amorenota/Three-Stage-BJT-Audio-Amplifier/hardware/breadboard_implementation.jpg

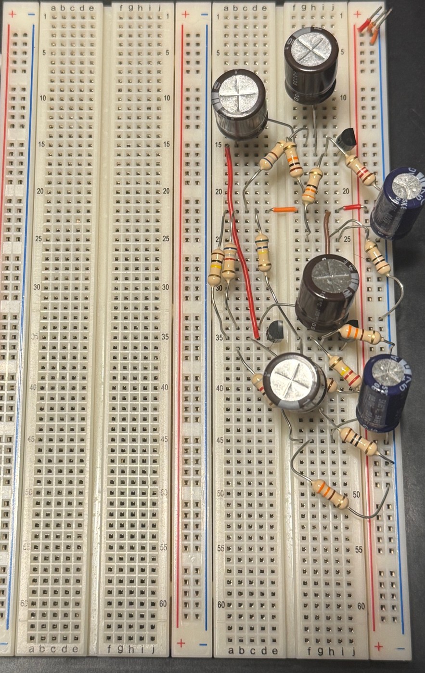
hardware/breadboard_implementation.jpg
