amorenota/Three-Stage-BJT-Audio-Amplifier/reports/progress_report_2.pdf

Adrian Moreno Talavera (SID: 011479859)

Carson Middaugh (SID: 011845185)

Design Project: Progress Report 1

Table 1: Specifications of Amplifier Design
VT | | VCC | AV1 | AV2 | AV3 | VE | IC | VBE | /(1+ ) | iR1
25 mV | 100 | 12 V | -15.6 | -16,8 | 1 | 0.4 V | 1 mA | 0.7 V | 1 | 10Ib

Analysis/Calculations:
Provide appropriate calculations that explain/show how the important parameters associated with each block in the system were determined/designed. Your discussion must also include the process/calculations followed towards determining the schematic component (e.g. resistor, capacitor, etc.) values.

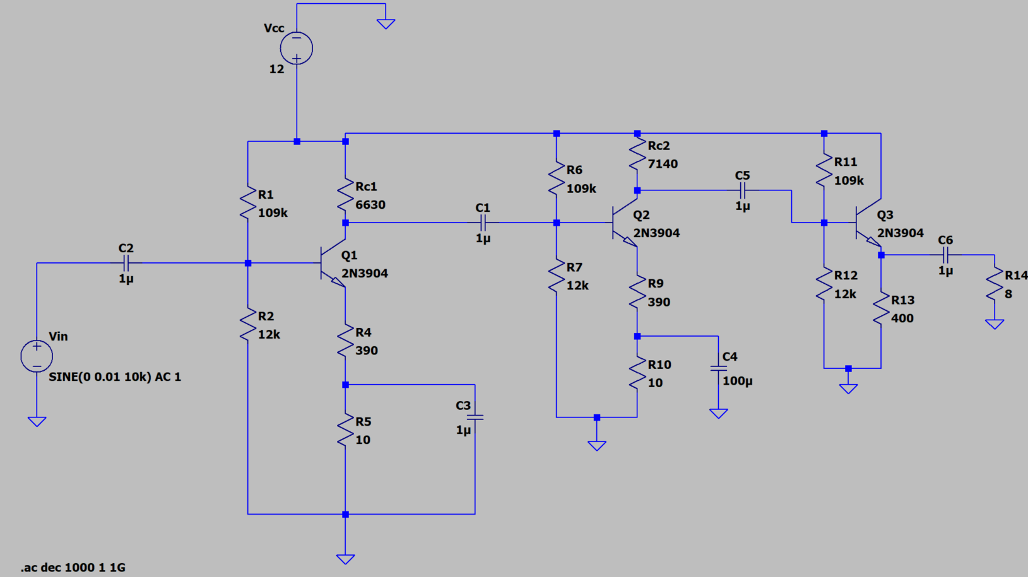
[picture p17: figure]

Figure 1: Cascaded Amplifier Schematic

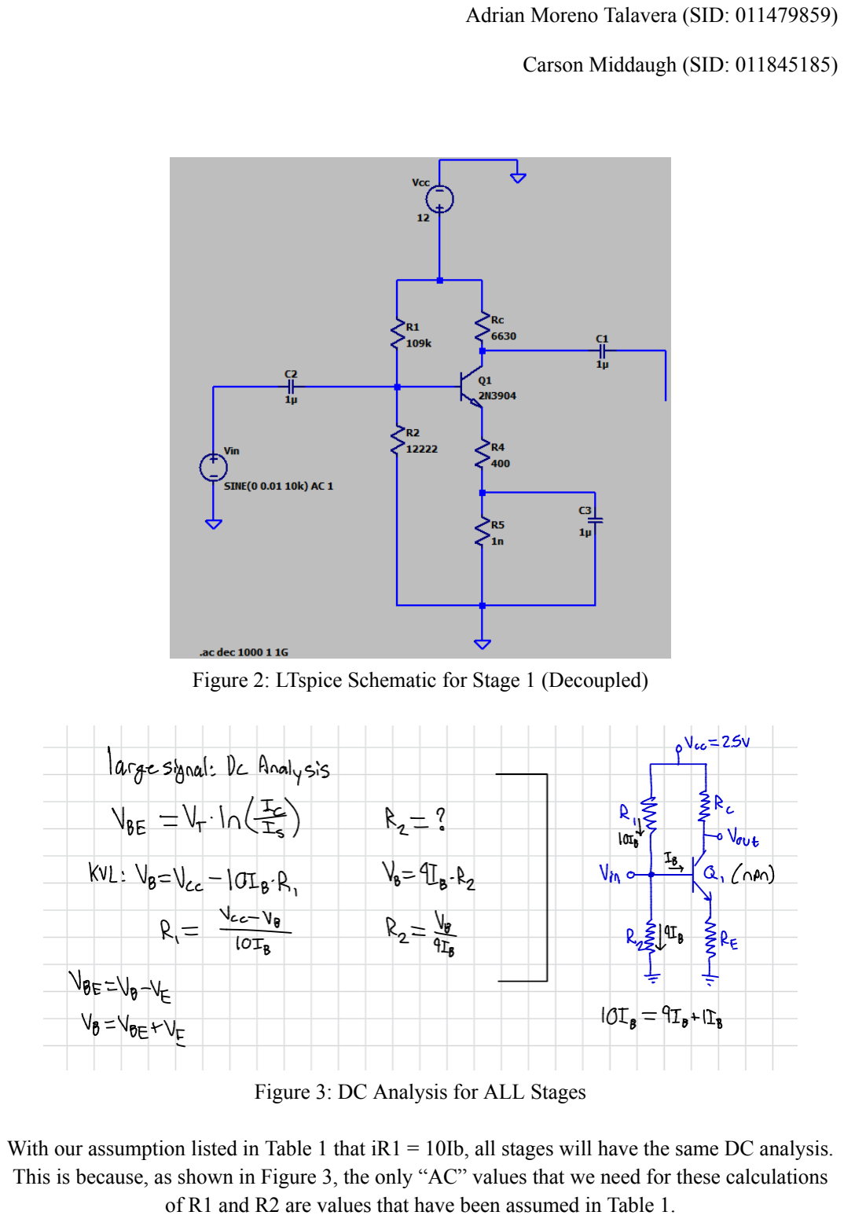
[picture p18: page 2]

Carson Middaugh (SID: 011845185)

Figure 2: LTspice Schematic for Stage 1 (Decoupled)

Figure 3: DC Analysis for ALL Stages

With our assumption listed in Table 1 that iR1 = 10Ib, all stages will have the same DC analysis. This is because, as shown in Figure 3, the only “AC” values that we need for these calculations of R1 and R2 are values that have been assumed in Table 1.

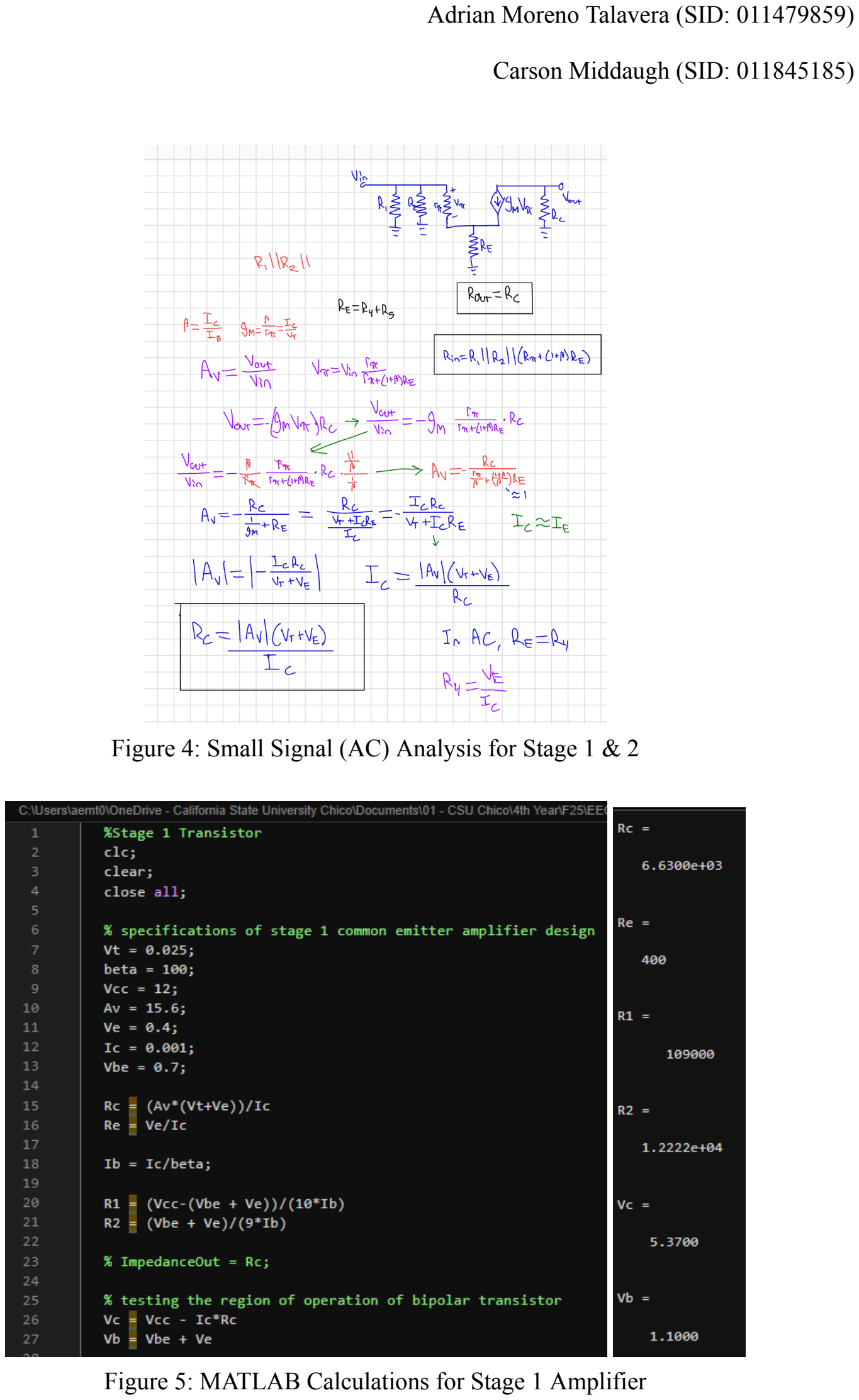
[picture p19: page 3]

Carson Middaugh (SID: 011845185)

Figure 4: Small Signal (AC) Analysis for Stage 1 & 2

Figure 5: MATLAB Calculations for Stage 1 Amplifier

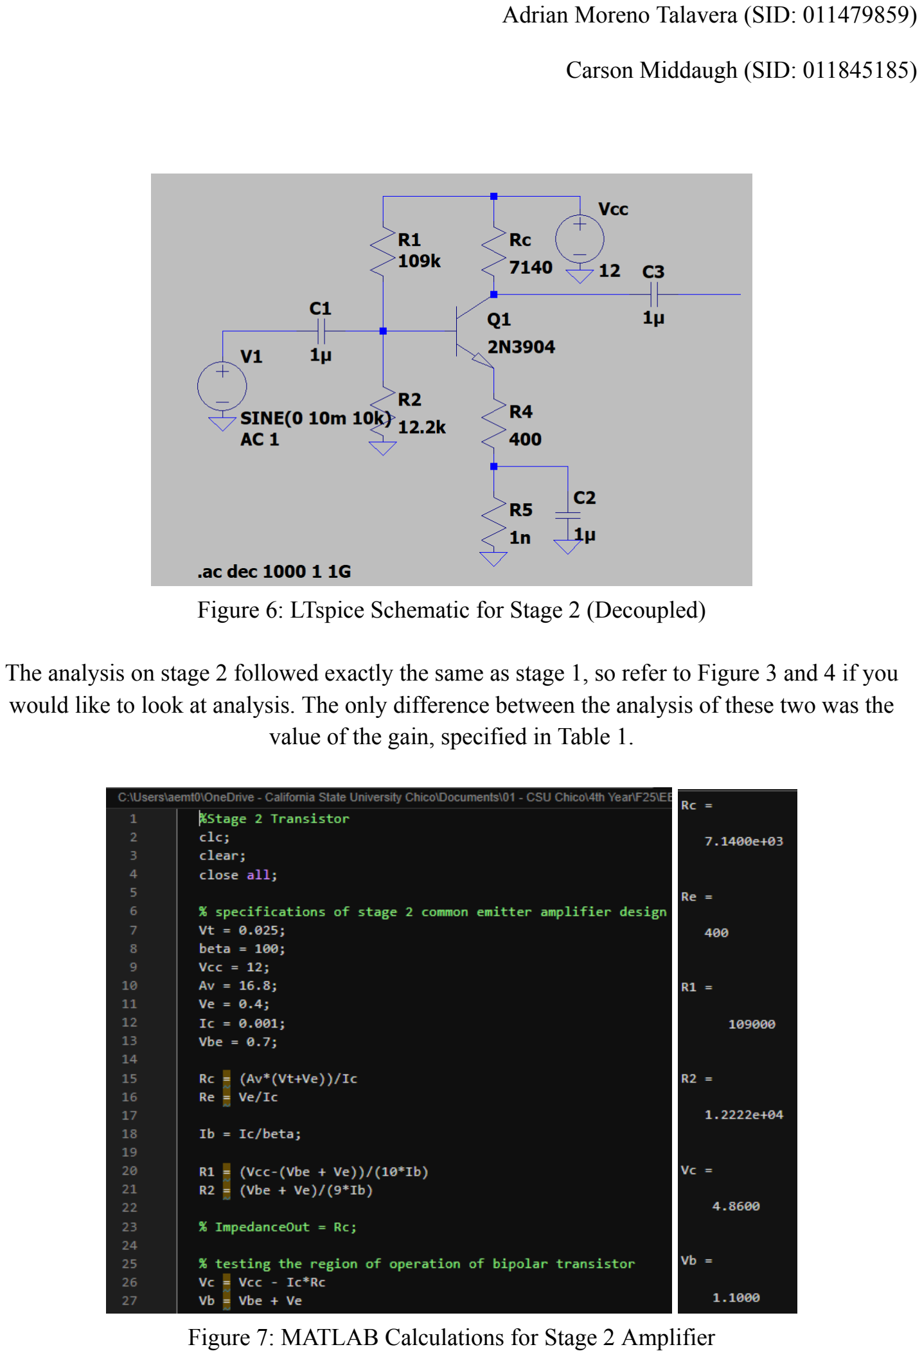
[picture p20: page 4]

Carson Middaugh (SID: 011845185)

Figure 6: LTspice Schematic for Stage 2 (Decoupled)

The analysis on stage 2 followed exactly the same as stage 1, so refer to Figure 3 and 4 if you would like to look at analysis. The only difference between the analysis of these two was the value of the gain, specified in Table 1.

Figure 7: MATLAB Calculations for Stage 2 Amplifier

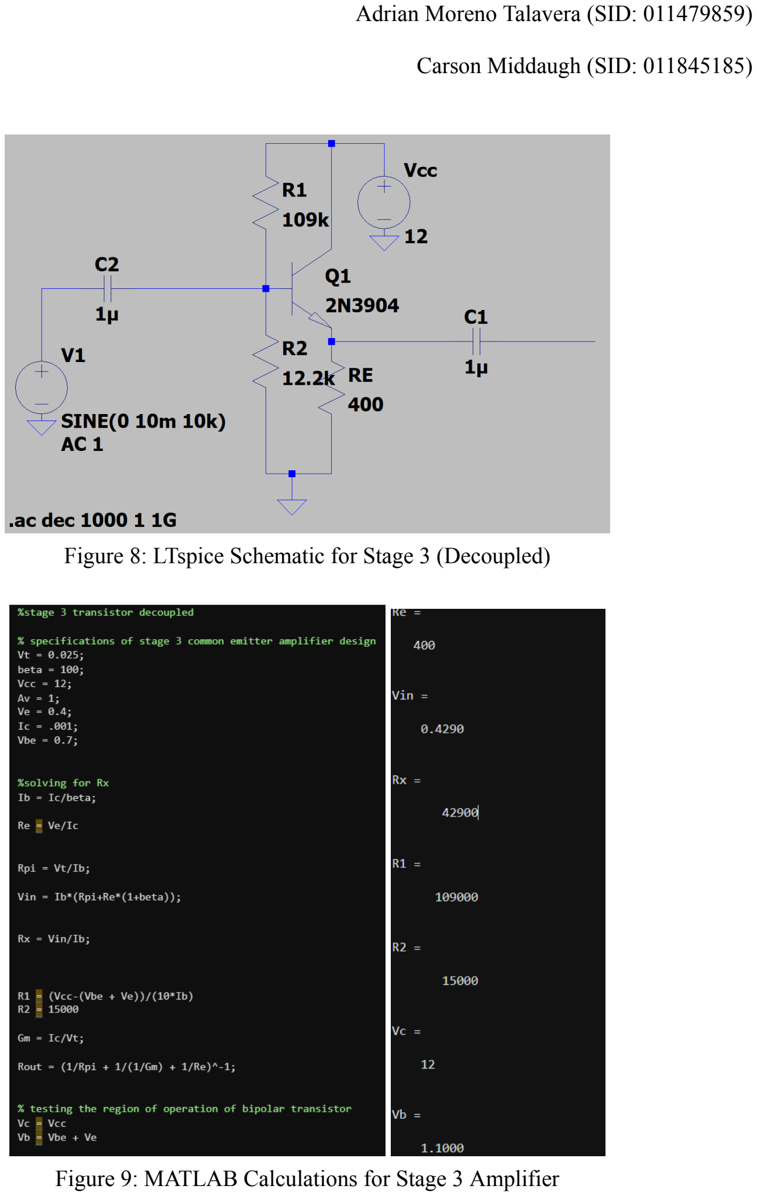
[picture p21: page 5]

Carson Middaugh (SID: 011845185)

Figure 8: LTspice Schematic for Stage 3 (Decoupled)

Figure 9: MATLAB Calculations for Stage 3 Amplifier

Carson Middaugh (SID: 011845185)

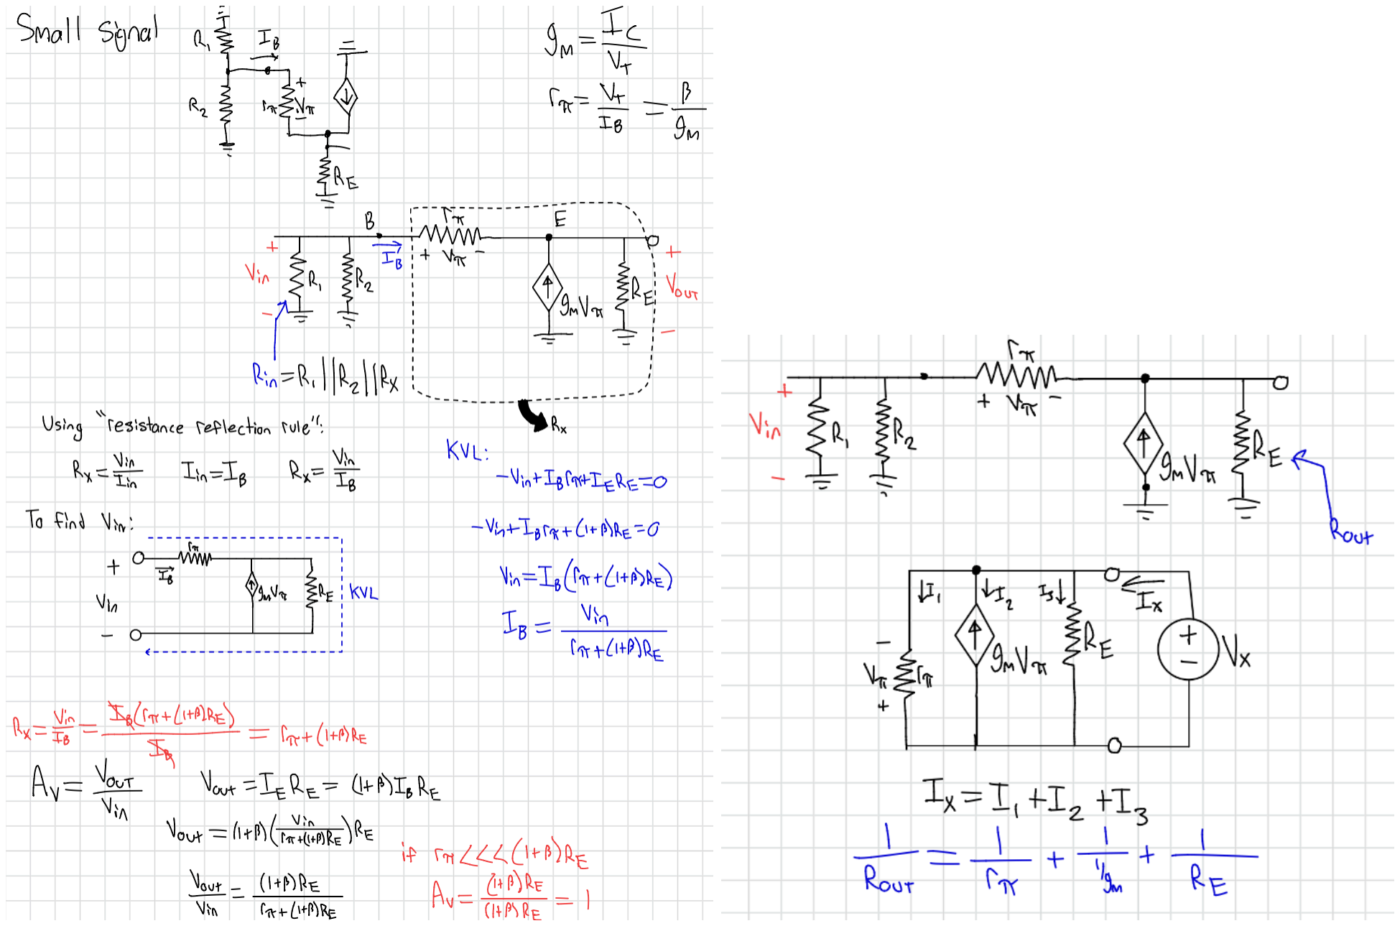
[picture p22: figure]

Figure 10: Small Signal (AC) Analysis for Stage 3

Carson Middaugh (SID: 011845185)

Simulations:

Simulating our cascaded amplifier without any modifications and solely with the calculations that we derived from large signal and small signal analysis, we saw that our Bode plot did not give the results we were looking for. Our overall gain was about 18.5, so we worked to change with impedance bridging. Below were some of our tests as we tried to determine the best course of action.

Table 2: Trial Runs Modifying Impedance Values (For Impedance Bridging)

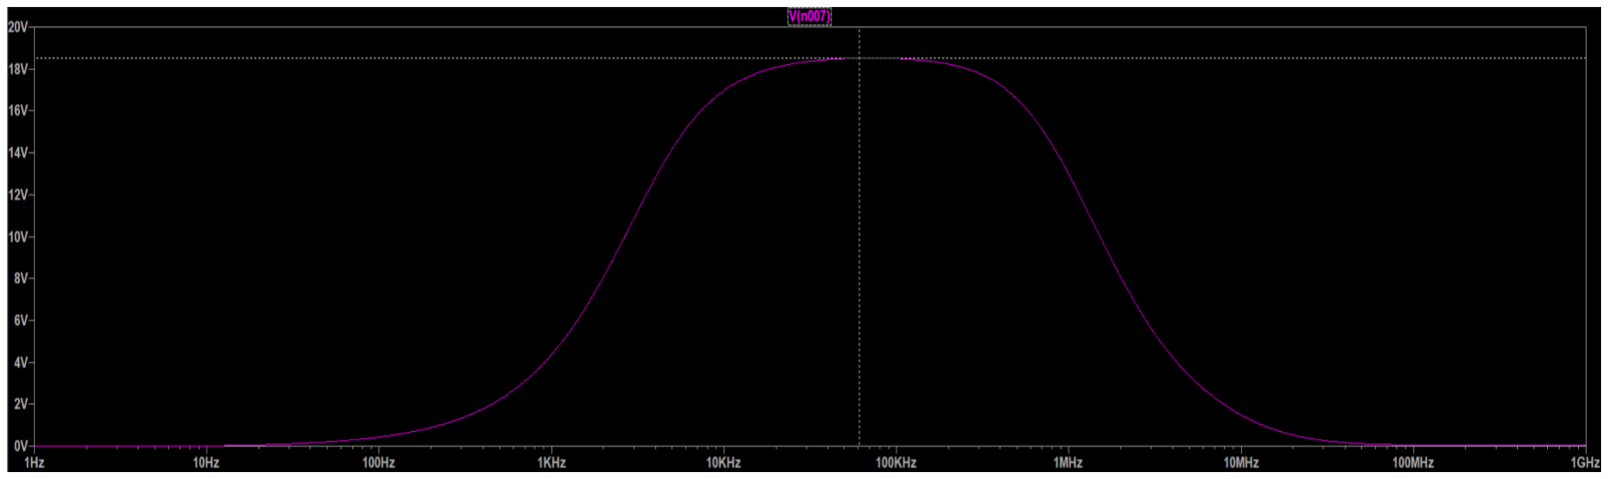
[picture p23: figure]

Figure 11: Gain for unmodified Amplifier (Gain = 18.5)

Iteration | R1 | R2 | Rc1 | R6 | R7 | Rc2 | R11 | R12 | C
1 (no modificatio n) | 109k | 12k | 6.6k | 109k | 12k | 7140 | 109k | 12k | 1u
2 | 109k | 12k | 6.6k | 109k | 12k | 7140 | 109k | 12k | 100u

3

4

5

Carson Middaugh (SID: 011845185)

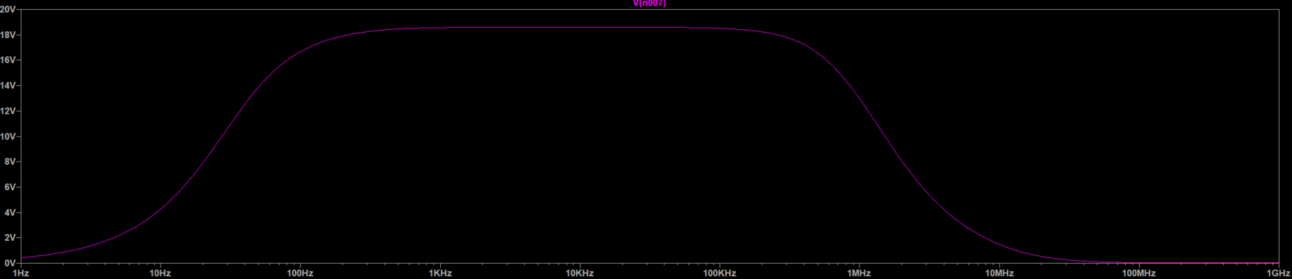
[picture p24: figure]

Figure 12: Gain for Amplifier (Iteration 2; Gain = 18.6)

In our second iteration, we wanted to shift the bode plot to the left, so we increased the capacitor values across the entire schematic to be 100 Microfarads instead of 1 microfarad. Although it shifted our bode plot to the left, it wasn’t as much as was needed, so there will eventually be more iterations with the capacitors to get the bode plot to where it needs to be.

Group member contributions (Roughly):

Adrian: Adding all of the schematics, matlab for stage 1 and 2, both tables, and starting the impedance iterations.

Carson: Adding all of the theory for all stages, matlab and schematic for stage 3, adding onto table 1.
