amorenota/Three-Stage-BJT-Audio-Amplifier/ltspice/Design_Project_Working_ImpedanceBridging.asc

C1: cap; 470µ
C2: cap; 470µ
C3: cap; 470µ
C4: cap; 470µ
C5: cap; 470µ
C6: cap; 470µ
Q1: npn; 2N3904
Q2: npn; 2N3904
Q3: npn; 2N3904
R1: res; 10k
R2: res; 1.2k
R4: res; 33
R5: res; 10
R6: res; 100k
R7: res; 12k
R9: res; 100
R10: res; 330
R11: res; 560k
R12: res; 220k
R13: res; 330
R14: res; 10
Rc1: res; 680
Rc2: res; 6.8k
Vcc: voltage; 12
Vin: voltage; SINE(0 0.01 10k) AC 1
Named nets: 0
.ac dec 1000 1 1G
.tran 1u 0.005
Adrian Moreno Talavera (SID: 011479859)
Carson Middaugh (SID: 011845185)
