amorenota/Three-Stage-BJT-Audio-Amplifier/ltspice/initial_calculated_design.asc

C1: cap; 1µ
C2: cap; 1µ
C3: cap; 1µ
C4: cap; 1µ
C5: cap; 1µ
C6: cap; 1µ
Q1: npn; 2N3904
Q2: npn; 2N3904
Q3: npn; 2N3904
R1: res; 109k
R2: res; 12k
R3: res; 6630
R4: res; 390
R5: res; 10
R6: res; 12k
R7: res; 109k
R8: res; 7140
R9: res; 390
R10: res; 10
R11: res; 109k
R12: res; 12k
R13: res; 400
RL: res; 8
Vcc: voltage; 12
Vin: voltage; SINE(0 10m 10k) AC 1
Named nets: 0
Adrian Moreno Talavera (SID: 011479859)
Carson Middaugh (SID: 011845185)
.ac dec 1000 1 1G
